aWanha/STM32LCRMeter/schematic.pdf

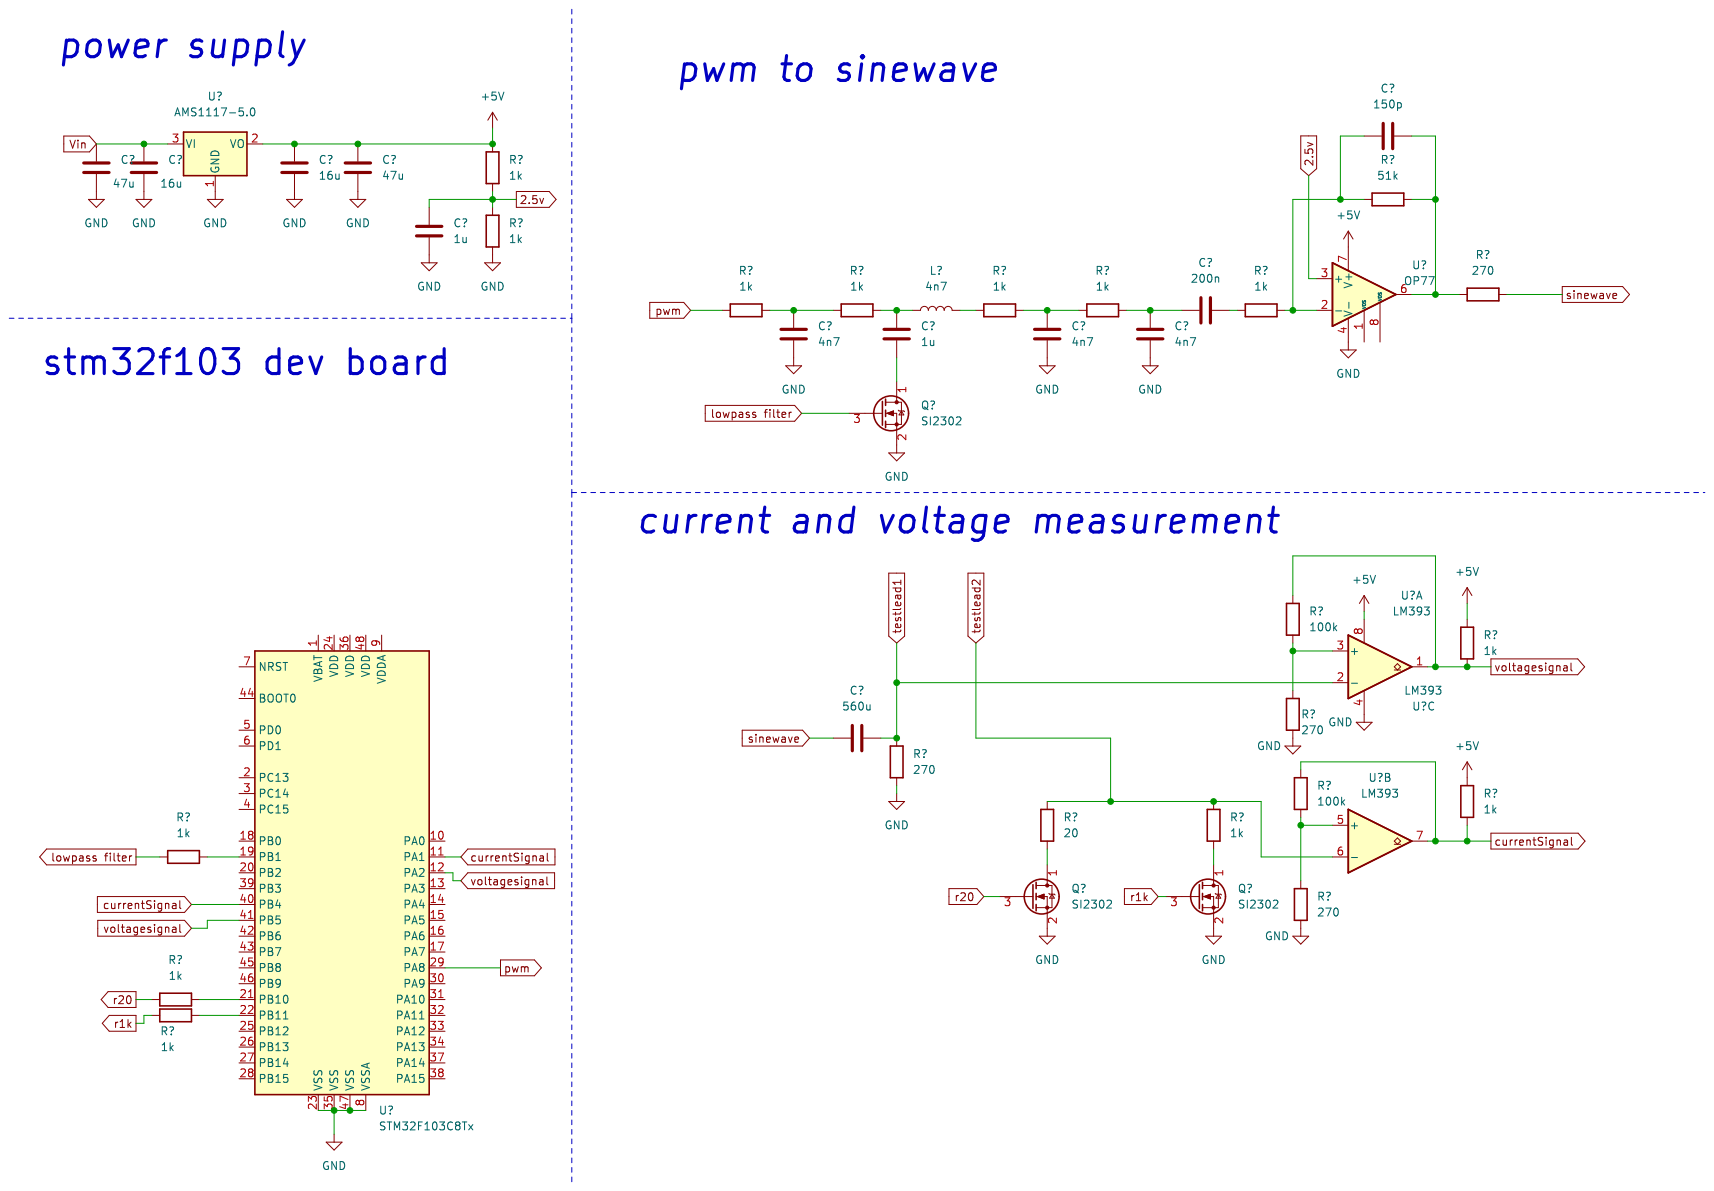
[picture p3: page 1]
