aWanha/STM32LCRMeter/stm32f103LCRMeter/Core/Src/main.c

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
/* Includes ------------------------------------------------------------------*/
#include "main.h"
#include "dma.h"
#include "tim.h"
#include "gpio.h"

/* USER CODE BEGIN Includes */
#include "stdio.h"
#include "string.h"
#include "math.h"
#include "LCRFunctions.h"
/* USER CODE END Includes */


void SystemClock_Config(void);
/* USER CODE BEGIN 0 */
uint8_t sineWaveArray[sineWaveArray_len];
/* USER CODE END 0 */

/**
  * @brief  The application entry point.
  * @retval int
  */
int main(void)
{
  /* USER CODE BEGIN 1 */

  //amplitudeCorrection to set the amplitude to within 200mV pk-pk, value reduces dutycycle width to lower amplitude
  sineWaveSettings Hz50; Hz50.frequency = 50; Hz50.amplitudeCorrection = 0.267857143, Hz50.lowpassFilter = 1;
  sineWaveSettings Hz1000; Hz1000.frequency = 1000; Hz1000.amplitudeCorrection = 0.240384615,Hz1000.lowpassFilter = 1;
  sineWaveSettings Hz10000; Hz10000.frequency = 10000; Hz10000.amplitudeCorrection = 0.319672131,Hz10000.lowpassFilter = 0;
  sineWaveSettings Hz50000; Hz50000.frequency = 50000; Hz50000.amplitudeCorrection = 0.339673913,Hz50000.lowpassFilter = 0;
  sineWaveSettings Hz100000; Hz100000.frequency = 100000; Hz100000.amplitudeCorrection = 1.0, Hz100000.lowpassFilter = 0;

  measureSettings measureSettings;
  /* USER CODE END 1 */

  /* MCU Configuration--------------------------------------------------------*/

  /* Reset of all peripherals, Initializes the Flash interface and the Systick. */
  HAL_Init();

  /* Configure the system clock */
  SystemClock_Config();

  /* Initialize all configured peripherals */
  MX_GPIO_Init();
  MX_DMA_Init();
  MX_TIM1_Init();
  MX_TIM2_Init();
  MX_TIM3_Init();
  MX_TIM4_Init();
  /* USER CODE BEGIN 2 */
  timerSettings();
  /* USER CODE END 2 */

  /* Infinite loop */
  /* USER CODE BEGIN WHILE */


  const uint16_t sampleN = 10;
  uint32_t average[sampleN];
  measureSettings.r20Active = 0;

  while (1)
  {
    for(uint8_t i = 0; i < resultSize; i ++){ //null all samples

      measureSettings.reactance[i] = 0;
      measureSettings.Farad_HenryResult[i] = 0;
      measureSettings.Farad_HenryResultR20[i]= 0;
      measureSettings.esrResult[i] = 0;
    }

    for(uint8_t k = 0; k < 2; k++){


      for(uint8_t j = 0; j < 5; j ++){ //simple states to iterate through frequencies

        if(j==0){
          createSineWave(&Hz50, sineWaveArray_len);
          measureSettings.frequency = Hz50.frequency;
        }
        if(j==1){
          createSineWave(&Hz1000,sineWaveArray_len);
          measureSettings.frequency = Hz1000.frequency;
        }
        if(j==2){
          createSineWave(&Hz10000,sineWaveArray_len);
          measureSettings.frequency = Hz10000.frequency;
        }
        if(j==3){
          createSineWave(&Hz50000,sineWaveArray_len);
          measureSettings.frequency = Hz50000.frequency;
        }
        if(j==4){
          createSineWave(&Hz100000,sineWaveArray_len);
          measureSettings.frequency = Hz100000.frequency;
        }

        if(measureSettings.r20Active){

          HAL_GPIO_WritePin(res20_GPIO_Port, res20_Pin, 1);

          HAL_GPIO_WritePin(res1k_GPIO_Port, res1k_Pin, 0);
          measureSettings.measureResistance = 20.54;
        }else{

          HAL_GPIO_WritePin(res20_GPIO_Port, res20_Pin, 0);

          HAL_GPIO_WritePin(res1k_GPIO_Port, res1k_Pin, 1);
          measureSettings.measureResistance = 1000;
        }

        HAL_Delay(500);
        measureSettings.currentLeading = currentLeading();

        measureLCR(average, sampleN,50);

        measureSettings.sample[j] = filterList(0.3, average, sampleN);
        measureSettings.resultIndex = j;
        calculateLCR(&measureSettings);
      }
      measureSettings.r20Active = !(measureSettings.r20Active);
    }
  }
    /* USER CODE END WHILE */

}

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
