aWanha/STM32LCRMeter/stm32f103LCRMeter/Core/Inc/main.h

#define lowpassFilter_Pin GPIO_PIN_1
#define lowpassFilter_GPIO_Port GPIOB
#define res20_Pin GPIO_PIN_10
#define res20_GPIO_Port GPIOB
#define res1k_Pin GPIO_PIN_11
#define res1k_GPIO_Port GPIOB
#define sineWaveArray_len 8192
#define clockFreq 72000000
#define clockMHz (clockFreq / 1000000)
#define voltageRising TIM_SR_CC1IF_Msk
#define voltageFalling TIM_SR_CC2IF_Msk
#define currentRising TIM_SR_CC3IF_Msk
#define currentFalling TIM_SR_CC4IF_Msk
#define resultSize 5
